fbaillon19/poulailler-automatique/photos/poulailler_schéma.jpg

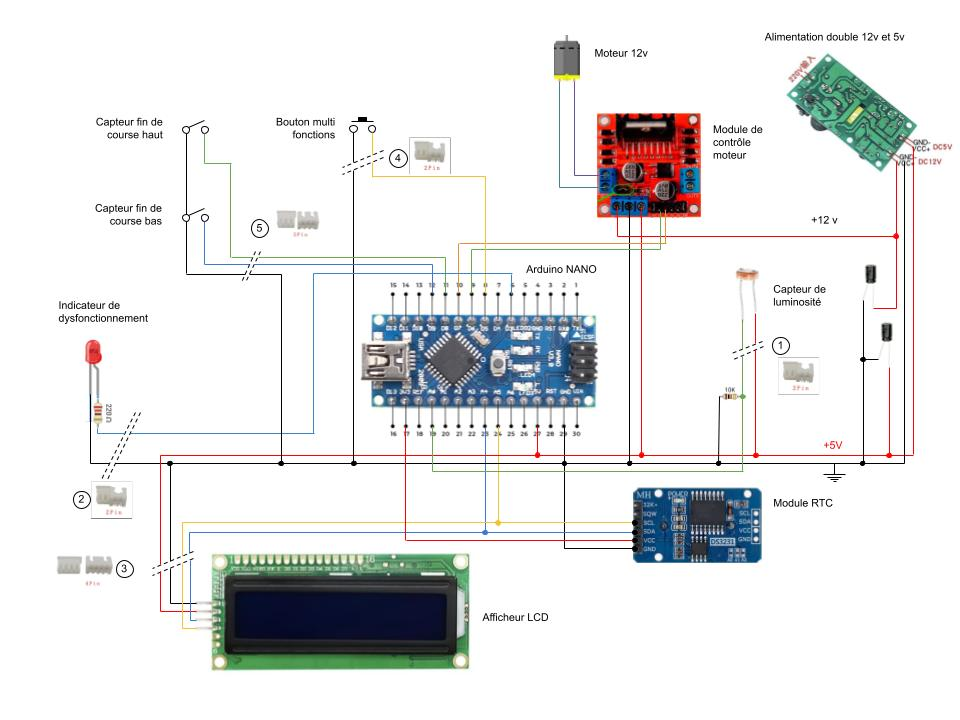
photos/poulailler_schéma.jpg
