fbaillon19/poulailler-automatique/docs/testing/README.md

# 🧪 Testing & Validation Guide

> Comprehensive testing procedures for the Automatic Chicken Coop Door project

## 📋 Overview

This directory contains all testing procedures to validate your chicken coop door system before deployment. Testing is divided into systematic phases to isolate and verify each component individually.

## 📚 Test Documentation

| Document | Description | Duration |
|---|---|---|
| **[Hardware Tests](hardware_tests.md)** | Power supply, modules, and sensors validation | ~1 hour |
| **[Software Tests](software_tests.md)** | User interface and system integration tests | ~45 minutes |
| **[Troubleshooting Guide](troubleshooting.md)** | Common issues and solutions | Reference |

## 💻 Test Codes

Pre-written Arduino sketches for individual component testing:

```
test_codes/
├── test_arduino/test_arduino.ino       - Basic Arduino functionality
├── test_rtc/test_rtc.ino               - RTC DS3231 time keeping
├── test_lcd/test_lcd.ino               - LCD I2C display
├── test_sensors/test_sensors.ino       - Light sensor + limit switches
├── test_button/test_button.ino         - Multi-function button
├── test_led/test_led.ino               - Status LED blinking
├── test_motor/test_motor.ino           - L298N motor control
└── test_complete/test_complete.ino     - Full system integration
```

### **How to use with Arduino IDE:**
1. **File → Open** → Navigate to `docs/testing/test_codes/test_xxx/test_xxx.ino`
2. **Upload** to Arduino Nano
3. **Tools → Serial Monitor** (9600 baud)
4. **Follow** the test procedure displayed in serial monitor

## ⚡ Quick Start Testing

### **Phase 1: Basic Electronics** (30 min)
```bash
1. Verify power supply outputs (12V & 5V)
2. Test Arduino Nano programming
3. Validate RTC time keeping
4. Check LCD display functionality
```

### **Phase 2: Sensors & Controls** (30 min)
```bash
1. Test light sensor variations
2. Verify limit switches detection
3. Test button short/long press
4. Check LED blinking pattern
```

### **Phase 3: Motor & Integration** (30 min)
```bash
1. Validate motor control (both directions)
2. Test complete user interface
3. Verify timing logic and delays
4. Full system integration test
```

## ✅ Validation Checklist

Track your testing progress:

### **Hardware Validation**
- [ ] **Power Supply** - 12V & 5V stable outputs
- [ ] **Arduino Nano** - Programming and serial communication
- [ ] **RTC Module** - Time keeping and I2C communication
- [ ] **LCD Display** - Text display and I2C communication
- [ ] **Light Sensor** - Analog readings with light variations
- [ ] **Limit Switches** - Digital state changes when activated
- [ ] **User Button** - Short press and long press detection
- [ ] **Status LED** - Controlled blinking pattern
- [ ] **Motor Control** - Both directions via L298N

### **Software Validation**
- [ ] **User Interface** - LCD menu navigation
- [ ] **Settings Storage** - EEPROM save/load functionality
- [ ] **Time Logic** - 7 AM opening, 11 PM closing
- [ ] **Light Logic** - Closing with 10-minute delay
- [ ] **Safety Logic** - Obstacle detection and timeout
- [ ] **Manual Override** - Button door control

### **Integration Validation**
- [ ] **Complete Cycle** - Automatic opening and closing
- [ ] **Safety Systems** - All timeout and error detection
- [ ] **User Experience** - Settings adjustment via button/LCD
- [ ] **Reliability** - 24-hour continuous operation test

## 🚨 Safety Reminders

**⚠️ Before starting any tests:**

- **Electrical Safety**: 220V mains power - ensure enclosure is closed
- **Motor Safety**: Initial tests with motor disconnected from mechanical system
- **Component Protection**: Verify power supply voltages before connecting modules
- **Documentation**: Record all test results for troubleshooting

## 🛠️ Required Tools

- Multimeter (voltage and resistance measurements)
- Arduino IDE (for uploading test codes)
- Computer with USB port (for serial monitoring)
- Smartphone flashlight (for light sensor testing)
- Small screwdriver (for adjustments)

## 📞 Getting Help

If you encounter issues during testing:

1. **Check [Troubleshooting Guide](troubleshooting.md)** for common solutions
2. **Review wiring diagrams** in the main documentation
3. **Open an issue** using our [test failure template](../../.github/ISSUE_TEMPLATE/test_failure.md)
4. **Join discussions** in the project's GitHub discussions

## 🏆 Success Criteria

Your system is ready for installation when:
- ✅ All individual components pass their tests
- ✅ Complete system operates for 24 hours without errors
- ✅ All safety systems respond correctly
- ✅ User interface is fully functional
- ✅ Settings persist through power cycles

---

**Happy testing! 🐔** 

*A well-tested system is a reliable system.*
