fbaillon19/poulailler-automatique/(commit log)

2025-09-03 Ajout .gitignore pour dossiers de travail
2025-09-03 Internationalisation des README
2025-09-05 Mise à jour de la liste des composants
2025-09-13 Add complete testing framework with all test codes
    - Hardware tests: arduino, rtc, lcd, sensors, button, led, motor
    - Integration test: complete system validation
    - Comprehensive diagnostics and troubleshooting guides
    - Safety procedures for motor testing
    - All tests compatible with Arduino IDE folder structure
2025-09-13 Mise à jour du fichier de test du bouton
2025-09-14 Migrate technical documentation to English
    - Remove French technical docs (guide_cablage, liste_composants, guide_montage, schema_description)
    - Add English equivalents (wiring_guide, components_list, assembly_guide, fritzing_description)
    - Add new testing and troubleshooting guides (hardware_tests, software_tests, troubleshooting)
    - Keep only README files bilingual as agreed
    - Project now ready for international community
2025-09-15 Complete migration to English + Arduino IDE structure fix
    - Fix Arduino IDE structure: code/poulailler_automatique/poulailler_automatique.ino
    - Remove arduino_workspace redundant folder
    - Convert all test codes from French to English
    - Maintain consistent numbering with hardware/software test guides
    - Update test_codes README.md to English
    - All technical documentation now in English (except main README files)
    - Project ready for international maker community
    [poulailler_automatique.ino, test_arduino.ino, test_complete.ino, test_lcd.ino, test_led.ino, test_motor.ino, test_rtc.ino, test_sensors.ino]
2025-09-15 Restore code directory with proper Arduino IDE structure
    - Add back code/poulailler_automatique/poulailler_automatique.ino
    - Maintain proper Arduino IDE folder structure
    - File was accidentally removed from Git tracking
2025-09-29 Memory optimization + L298N wiring fix + all tests validated
    MEMORY OPTIMIZATION (Critical fix):
    - All .ino files: Applied F() macro to string literals
    - poulailler_automatique.ino: 89% → 70% RAM usage (219 → ~500 bytes free)
    - test_complete.ino: Fixed 100 → 1550 bytes free RAM
    - Stable operation now guaranteed on Arduino Nano 2KB RAM
    CODE FIXES:
    - test_button.ino: Fixed long press detection logic
    - test_button.ino: Fixed statistics timing (10s intervals + 60s summary)
    - test_lcd.ino: Fixed character array (missing $ character)
    - All tests: Homogeneous F() macro usage for consistency
    HARDWARE DOCUMENTATION:
    - docs/wiring_guide.md: Added critical L298N jumper removal instructions
    - Do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
    [poulailler_automatique.ino, test_arduino.ino, test_complete.ino, test_lcd.ino, test_led.ino, test_motor.ino, test_rtc.ino, test_sensors.ino]
2025-09-30 📝 Update documentation for v1.1.0
    - Add LCD backlight management features
    - Add light sensor hysteresis documentation
    - Add configuration section with customizable constants
    - Create CHANGELOG.md
    - Update version badge to 1.1.0
    - Document all bug fixes and improvements
    [poulailler_automatique.ino]
2025-12-25 🎉 Version 1.2.0 - Refactorisation avec OneButton
    ✨ Nouveautés:
    - Architecture modulaire (button.h, button.cpp)
    - Bibliothèque OneButton pour gestion bouton robuste
    - Messages debug Serial détaillés
    - Rallumage automatique LCD lors transitions
    - Définitions enum explicites
    🐛 Corrections:
    - Bug affichage modes timeout résolu
    - Gestion scope variables dans switch/case
    - LCD s'éteint après 30s inactivité
    📚 Documentation:
    - README.md mis à jour
    - CHANGELOG.md complet
    - Guide OneButton (README_v1.2.0.md)
    [poulailler_automatique.ino]
2025-12-27 🎉 Version 1.3.0 - Encodeur rotatif KY-040
    - Encodeur rotatif KY-040 pour interface professionnelle
    - Bibliothèque Encoder de Paul Stoffregen (ultra-fiable)
    - Rotation pour modifier valeurs (±1 par cran)
    - Architecture procédurale simplifiée
    - Suppression bugs click/double-click
    - Blocages LCD résolus (rafraîchissement throttlé)
    - Direction rotation correcte (CW incrémente)
    - README.md et CHANGELOG.md mis à jour
    - Guide encodeur KY-040 (README_v1.3.0.md)
    - Instructions câblage condensateurs 100nF
    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
    [poulailler_automatique.ino, rotary_encoder.cpp, rotary_encoder.h]
2026-01-13 🎉 Version 1.4.0 - Version production terrain
    - Heure minimum fermeture (15h-17h) - Évite fermeture immédiate hiver
    - Temporisation paramétrable (10-30 min)
    - Affichage luminosité temps réel (alterne avec heure)
    - Calibration automatique au démarrage
    - Gestion d'erreurs complète (capteurs, RTC, tension)
    - LED clignotement différencié (200ms/1s/500ms)
    - Acquittement erreurs (appui 5s)
    - 10 modes de réglage au total
    🔧 Interface améliorée:
    - Appui long 1.5s (au lieu de 3s)
    - Navigation par appui bref entre modes
    - Seuil par défaut 100 (validé terrain)
    - Erreur RTC figé (faux positif)
    - Clignotement désagréable heures
    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
    [poulailler_automatique.ino, rotary_encoder.cpp, rotary_encoder.h]
2026-01-13 Fix: réduction taille des images
2026-01-13 🐛 Fix: Vérification RTC figé (faux positifs)
    [poulailler_automatique.ino]
2026-01-14 🐛 Fix: Capteur luminosité faux positif la nuit
    [poulailler_automatique.ino]
2026-01-19 ⚡ Perf: Optimisation test capteur luminosité
    Optimisations:
    - 2 tests max par jour (au lieu de 6000)
    - Test à 13:00:00 + confirmation à 13:01:00
    - Test UNIQUEMENT lumiere=0 (cas critique)
    - Ignore lumiere=1023 (soleil, pas dangereux)
    Logique:
    - lumiere=1023 à 13h → pas de risque (fermeture 23h OK)
    - lumiere=0 à 13h → CRITIQUE (poules dehors)
    - Confirmation après 1 min évite glitches
    - Affichage temps réel disponible (bouton encodeur)
    Avantages:
    - CPU économisé
    - Pas de faux positifs
    - Focus sur cas critique uniquement
    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
    [poulailler_automatique.ino]
